TraccySolutions/1892-Eten-en-Drinken-Trapverlichting-PCB-design/Pics/Raw/Trap4.jpg

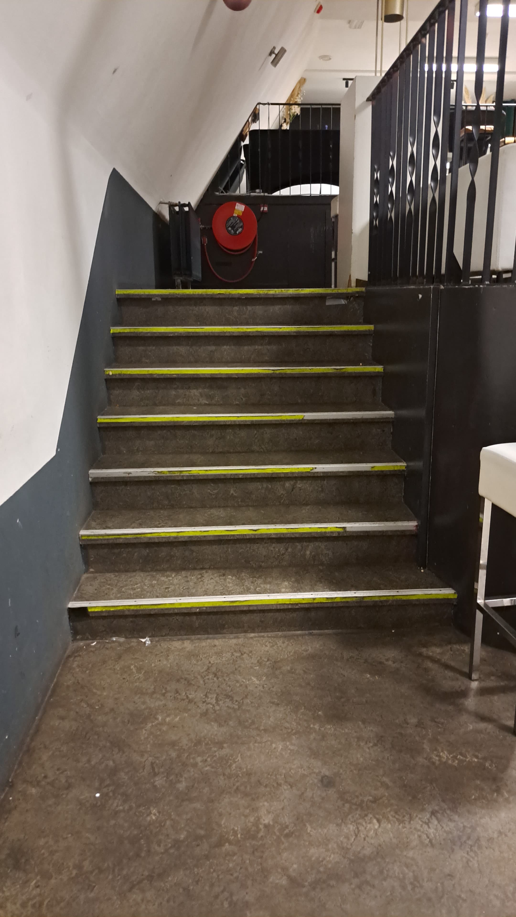
Pics/Raw/Trap4.jpg
