TraccySolutions/1892-Eten-en-Drinken-Trapverlichting-PCB-design/Pics/Raw/Trap2.jpg

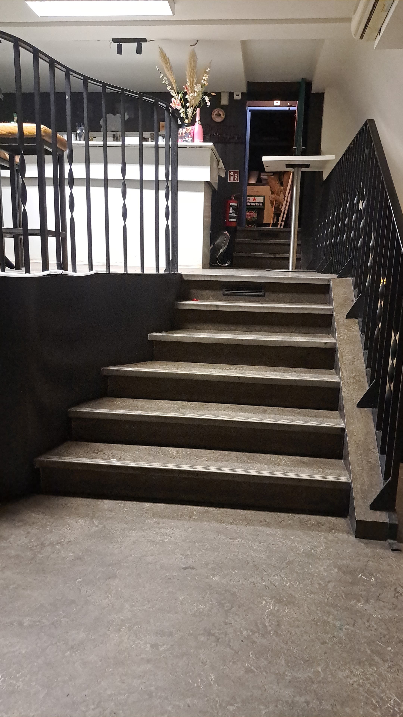
Pics/Raw/Trap2.jpg
