TraccySolutions/1892-Eten-en-Drinken-Trapverlichting-PCB-design/Pics/Raw/Trap1.jpg

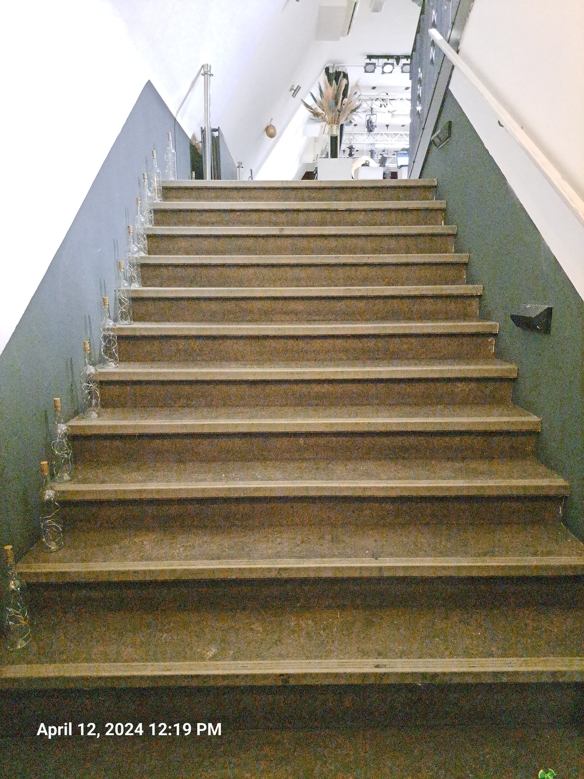
Pics/Raw/Trap1.jpg
