TraccySolutions/1892-Eten-en-Drinken-Trapverlichting-PCB-design/Pics/Raw/Trap3.jpg

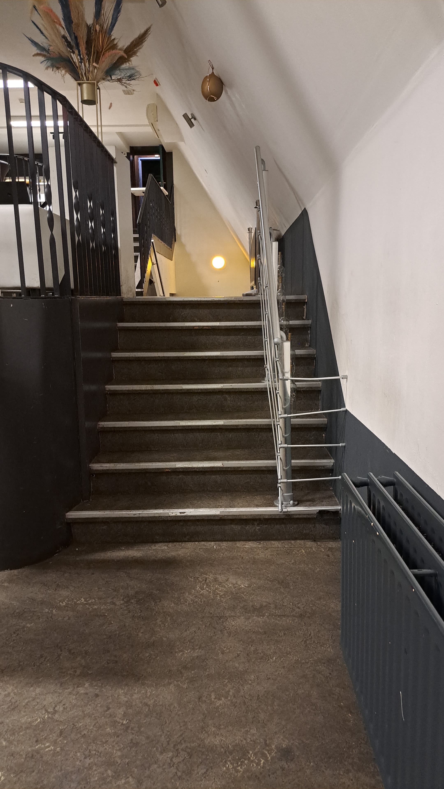
Pics/Raw/Trap3.jpg
