TraccySolutions/1892-Eten-en-Drinken-Trapverlichting-PCB-design/Schematic/V1/Case/PCB.step

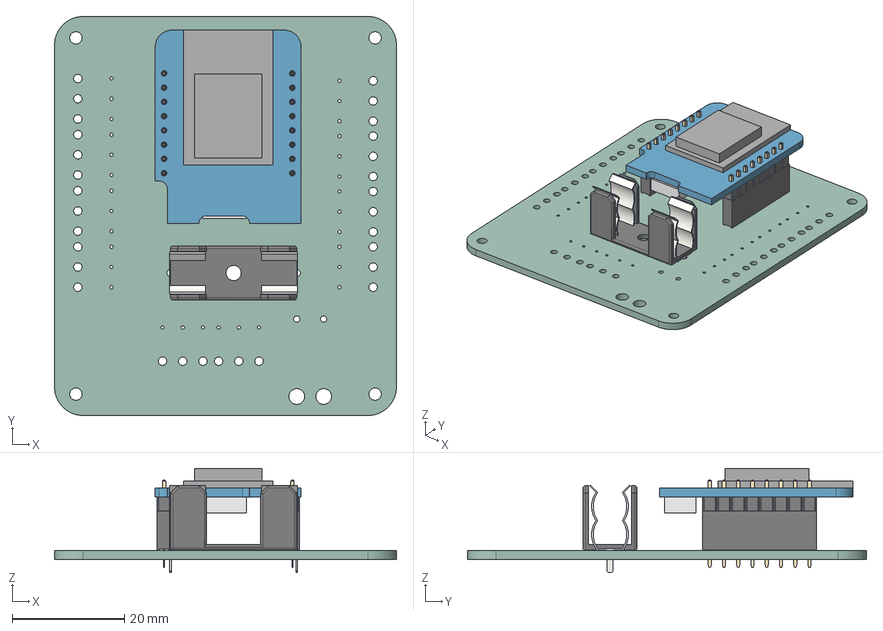
[picture p5: CAD file, 2024-04-18, an earlier design]
Schematic/V1/Case/PCB.step
61.0 x 71.1 x 18.6 mm
wemos_d1_mini_light
PinHeader_1x08_P254mm_Vertical x 2
PinSocket_1x08_P254mm_Vertical x 2
A_Schurter_0031_8201
V1_PCB
