TraccySolutions/1892-Eten-en-Drinken-Trapverlichting-PCB-design/(list of files, cad)

Other CAD files:
Schematic/V3/LIB_1812L200_16DR/1812L200_16DR/Allegro/1812l010dr.psm
Schematic/V3/LIB_1812L200_16DR/1812L200_16DR/DEHDL/1812l200_16dr/chips/chips.prt
