TraccySolutions/1892-Eten-en-Drinken-Trapverlichting-PCB-design/Schematic/V3/V3.kicad_pcb

## KiCad design Schematic/V3/V3.kicad_pcb (2024-08-20)

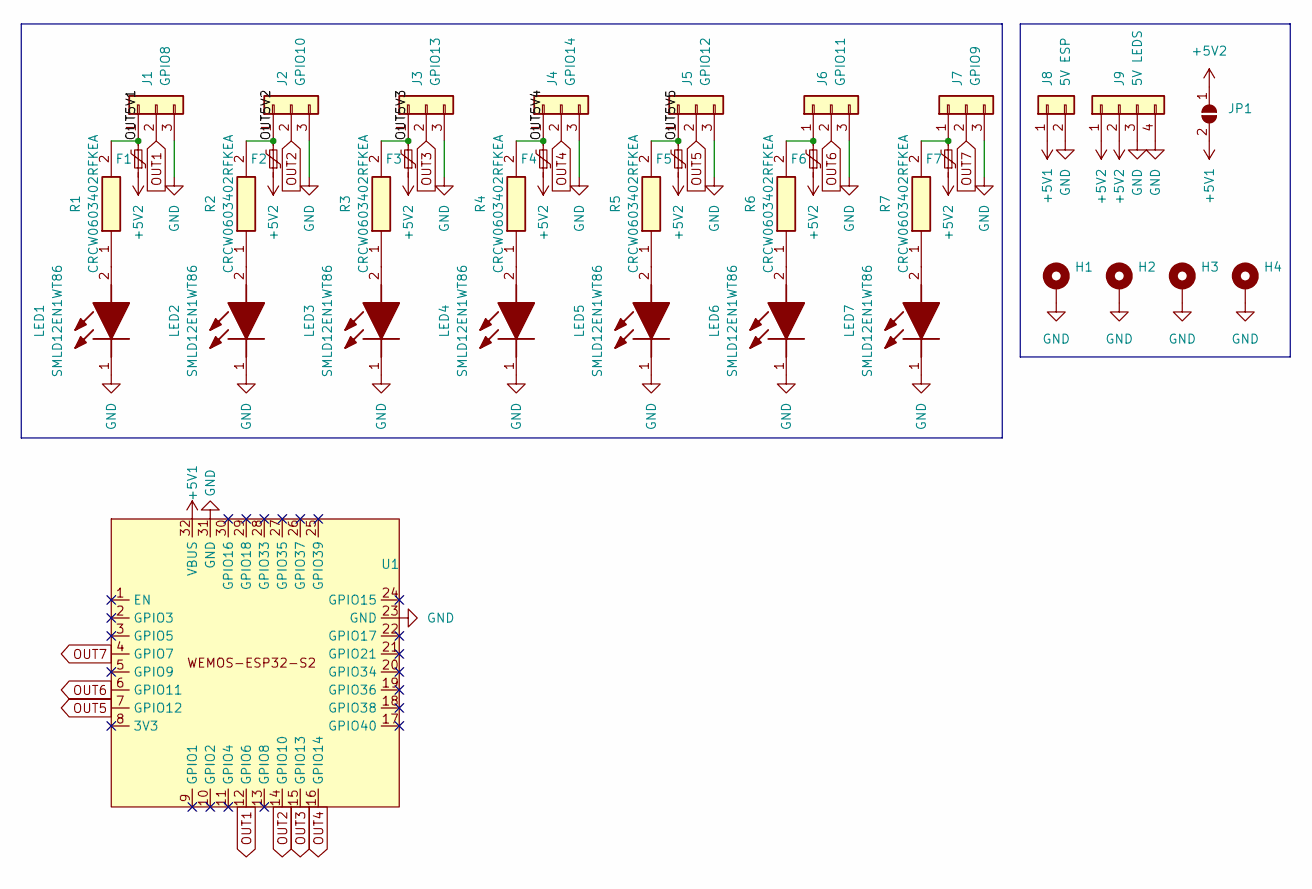
[picture p6: schematic V3.kicad_sch]

Parts:
F1, F2, F3, F4, F5, F6, F7: Polyfuse_Small; 1812L010DR; Mouser Part Number 652-MF-MSMF260-2
H1, H2, H3, H4: MountingHole_Pad; MountingHole_3.2mm_M3_ISO14580_Pad
J1: GPIO8; Custom solderWire 1x03 with relief
J2: GPIO10; Custom solderWire 1x03 with relief
J3: GPIO13; Custom solderWire 1x03 with relief
J4: GPIO14; Custom solderWire 1x03 with relief
J5: GPIO12; Custom solderWire 1x03 with relief
J6: GPIO11; Custom solderWire 1x03 with relief
J7: GPIO9; Custom solderWire 1x03 with relief
J8: 5V ESP; SolderWire-0.25sqmm_1x02_P4.2mm_D0.65mm_OD1.7mm_Relief
J9: 5V LEDS; Custom SolderWire 1x04 with relief
JP1: SolderJumper_2_Open; SolderJumper-2_P1.3mm_Open_TrianglePad1.0x1.5mm
LED1, LED2, LED3, LED4, LED5, LED6, LED7: SMLD12EN1WT86; LEDM168X65N; Mouser Part Number 755-SMLD12EN1WT86
R1, R2, R3, R4, R5, R6, R7: CRCW0603402RFKEA; RESC1608X50N; Mouser Part Number 71-CRCW0603-402-E3
U1: WEMOS-ESP32-S2

Connections:
+5V1: J8.1, JP1.2 (B), U1.32 (VBUS)
+5V2: F1.1, F2.1, F3.1, F4.1, F5.1, F6.1, F7.1, J9.1, J9.2, JP1.1 (A)
/OUT5V1: F1.2, J1.1, R1.2
/OUT5V2: F2.2, J2.1, R2.2
/OUT5V3: F3.2, J3.1, R3.2
/OUT5V4: F4.2, J4.1, R4.2
/OUT5V5: F5.2, J5.1, R5.2
GND: H1.1, H2.1, H3.1, H4.1, J1.3, J2.3, J3.3, J4.3, J5.3, J6.3, J7.3, J8.2, J9.3, J9.4, LED1.1 (K), LED2.1 (K), LED3.1 (K), LED4.1 (K), LED5.1 (K), LED6.1 (K), LED7.1 (K), U1.23 (GND), U1.31 (GND)
unnamed: F6.2, J6.1, R6.2
unnamed: F7.2, J7.1, R7.2
unnamed: LED1.2 (A), R1.1
unnamed: LED2.2 (A), R2.1
unnamed: LED3.2 (A), R3.1
unnamed: LED4.2 (A), R4.1
unnamed: LED5.2 (A), R5.1
unnamed: LED6.2 (A), R6.1
unnamed: LED7.2 (A), R7.1
OUT1: J1.2, U1.12 (GPIO6)
OUT2: J2.2, U1.14 (GPIO10)
OUT3: J3.2, U1.15 (GPIO13)
OUT4: J4.2, U1.16 (GPIO14)
OUT5: J5.2, U1.7 (GPIO12)
OUT6: J6.2, U1.6 (GPIO11)
OUT7: J7.2, U1.4 (GPIO7)

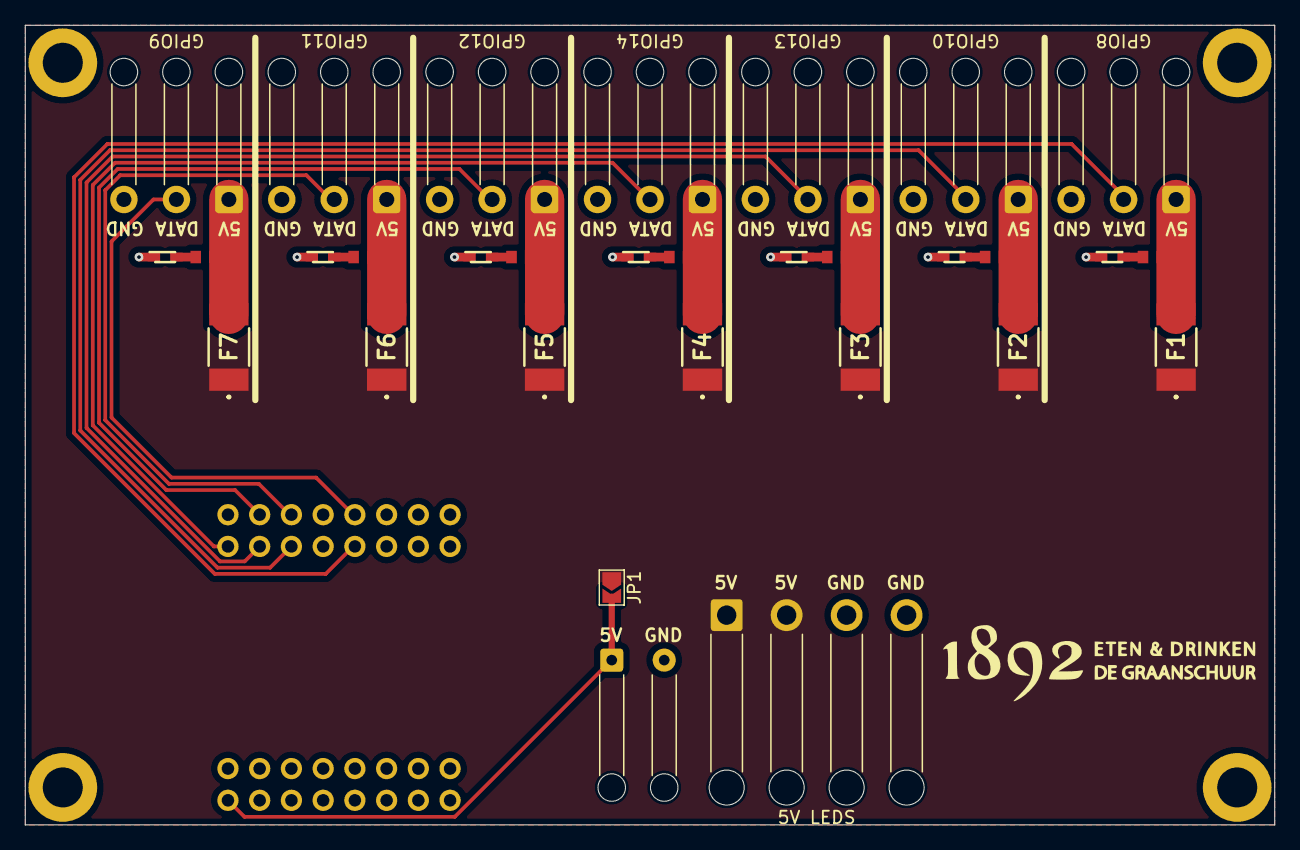
[picture p7: board V3.kicad_pcb from above]

Board: 2 copper layers, 100.0 x 64.0 mm, 36 parts (0 on the bottom side), 24 nets.
