TraccySolutions/1892-Eten-en-Drinken-Trapverlichting-PCB-design/Schematic/V2/V2.kicad_pcb

## KiCad design Schematic/V2/V2.kicad_pcb (2024-08-20, an earlier design)

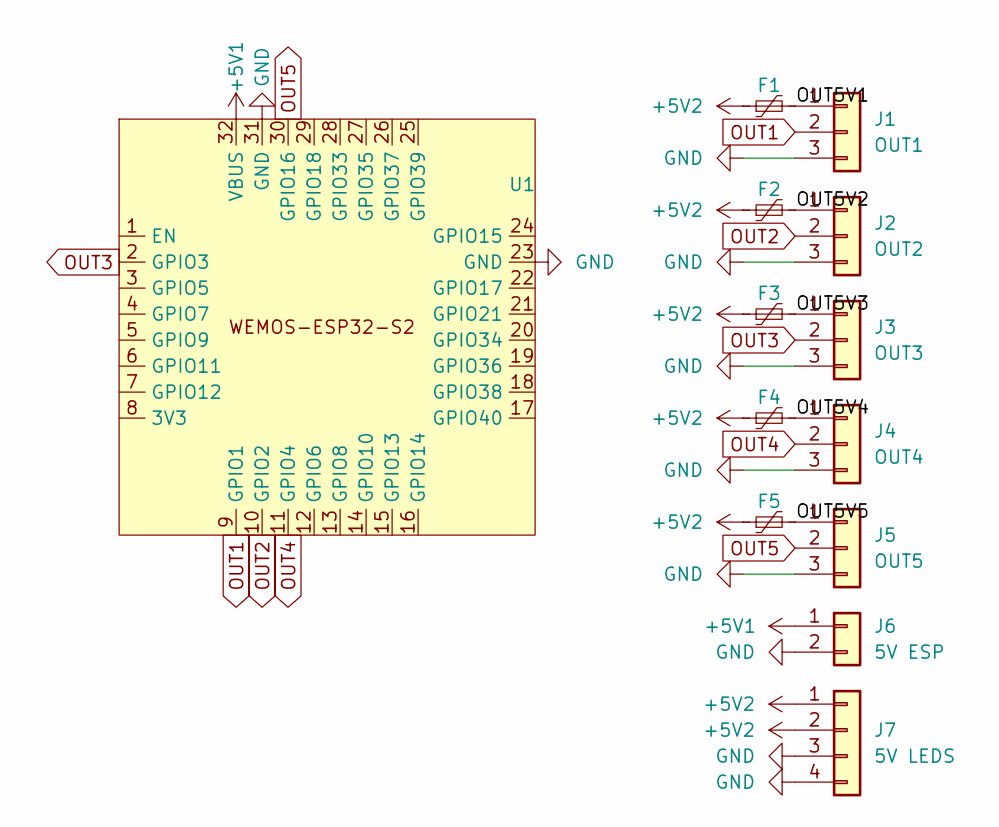
[picture p8: schematic V2.kicad_sch]

Parts:
F1, F2, F3, F4, F5: Polyfuse_Small; 1812L010DR
J1: OUT1; SolderWire-0.25sqmm_1x03_P4.2mm_D0.65mm_OD1.7mm_Relief
J2: OUT2; SolderWire-0.25sqmm_1x03_P4.2mm_D0.65mm_OD1.7mm_Relief
J3: OUT3; SolderWire-0.25sqmm_1x03_P4.2mm_D0.65mm_OD1.7mm_Relief
J4: OUT4; SolderWire-0.25sqmm_1x03_P4.2mm_D0.65mm_OD1.7mm_Relief
J5: OUT5; SolderWire-0.25sqmm_1x03_P4.2mm_D0.65mm_OD1.7mm_Relief
J6: 5V ESP; SolderWire-0.25sqmm_1x02_P4.2mm_D0.65mm_OD1.7mm_Relief
J7: 5V LEDS; SolderWire-0.75sqmm_1x04_P4.8mm_D1.25mm_OD2.3mm_Relief
U1: WEMOS-ESP32-S2

Connections:
+5V1: J6.1, U1.32 (VBUS)
+5V2: F1.1, F2.1, F3.1, F4.1, F5.1, J7.1, J7.2
/OUT5V1: F1.2, J1.1
/OUT5V2: F2.2, J2.1
/OUT5V3: F3.2, J3.1
/OUT5V4: F4.2, J4.1
/OUT5V5: F5.2, J5.1
GND: J1.3, J2.3, J3.3, J4.3, J5.3, J6.2, J7.3, J7.4, U1.23 (GND), U1.31 (GND)
OUT1: J1.2, U1.9 (GPIO1)
OUT2: J2.2, U1.10 (GPIO2)
OUT3: J3.2, U1.2 (GPIO3)
OUT4: J4.2, U1.11 (GPIO4)
OUT5: J5.2, U1.30 (GPIO16)

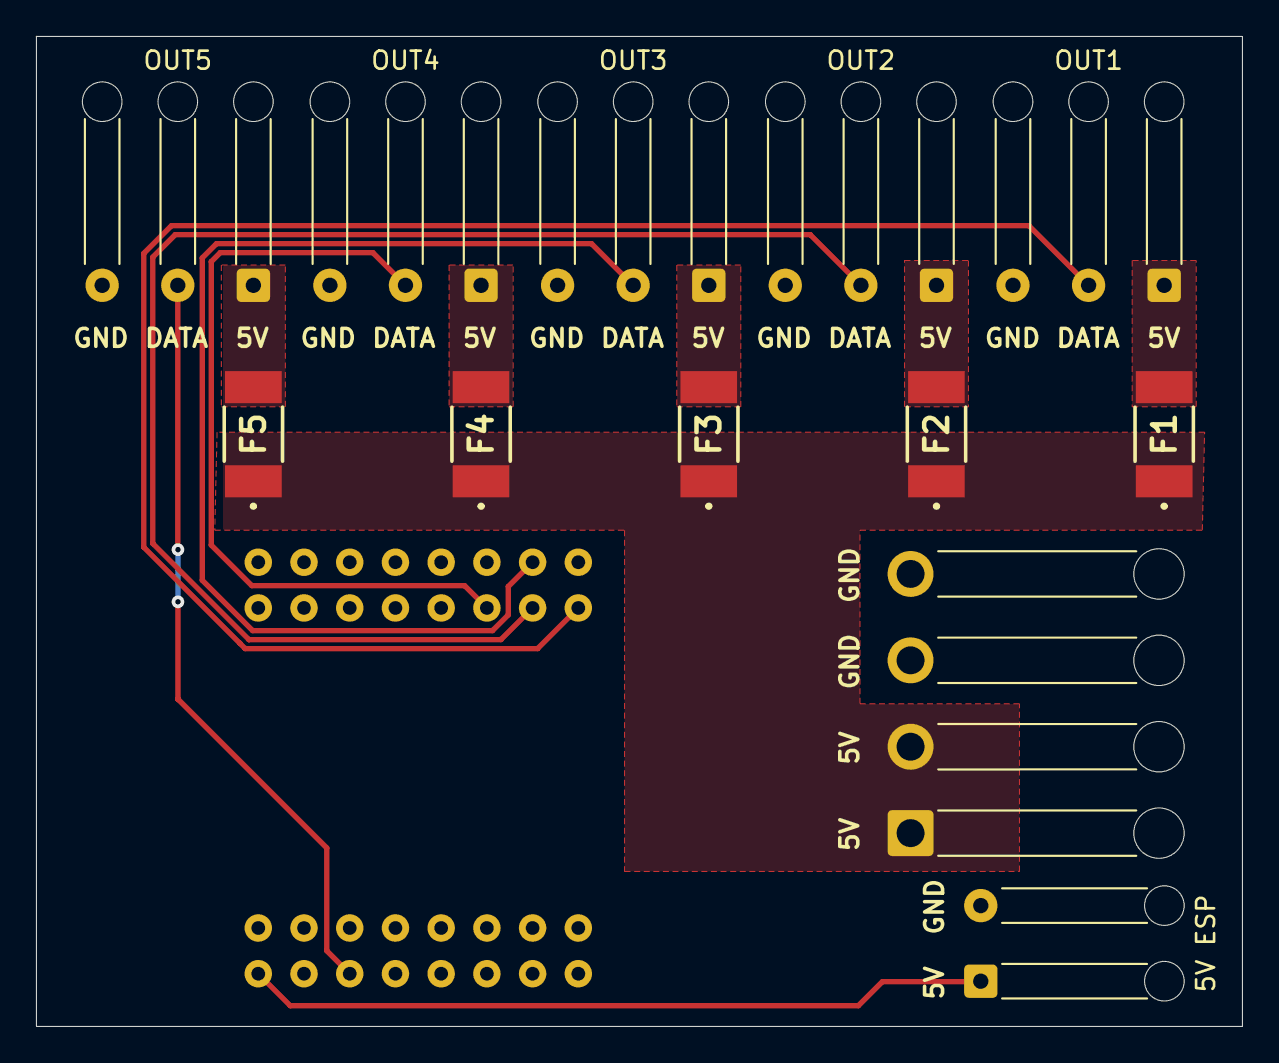
[picture p9: board V2.kicad_pcb from above]

Board: 2 copper layers, 67.0 x 55.0 mm, 13 parts (0 on the bottom side), 13 nets.
