TraccySolutions/1892-Eten-en-Drinken-Trapverlichting-PCB-design/Schematic/V1/V1.kicad_pcb

## KiCad design Schematic/V1/V1.kicad_pcb (2024-04-18, an earlier design)

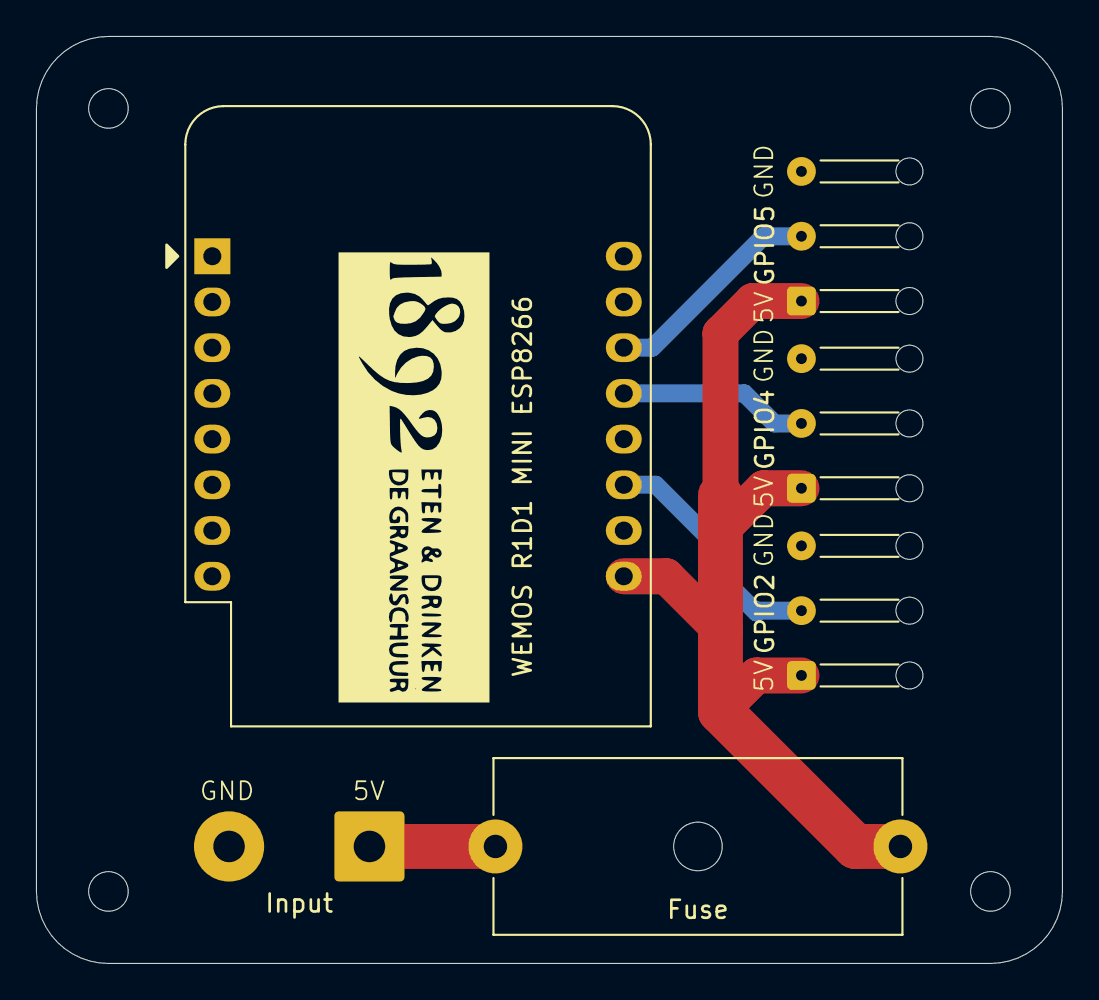
[picture p10: board V1.kicad_pcb from above]

Board: 2 copper layers, 57.0 x 51.5 mm, 10 parts (0 on the bottom side), 6 nets.

Parts:
Fuse: Fuse; Fuseholder_Cylinder-5x20mm_Schurter_0031_8201_Horizontal_Op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
GPIO2, GPIO4, GPIO5: Conn_01x03_Socket; SolderWire-0.1sqmm_1x03_P3.6mm_D0.4mm_OD1mm_Relief
H1, H2, H3, H4: MountingHole; MountingHole_2.2mm_M2
Input: Conn_01x02_Socket; SolderWire-1sqmm_1x02_P7.8mm_D1.4mm_OD3.9mm
WEMOS R1D1 MINI ESP8266: WeMos_D1_mini; WEMOS_D1_mini_light

Connections:
+5V: Fuse.1, GPIO2.1, GPIO4.1, GPIO5.1, WEMOS R1D1 MINI ESP8266.9 (5V)
D1: GPIO5.2, WEMOS R1D1 MINI ESP8266.14 (SCL/D1)
D2: GPIO4.2, WEMOS R1D1 MINI ESP8266.13 (SDA/D2)
D4: GPIO2.2, WEMOS R1D1 MINI ESP8266.11 (D4)
GND: GPIO2.3, GPIO4.3, GPIO5.3, Input.2, WEMOS R1D1 MINI ESP8266.10 (GND)
unnamed: Fuse.2, Input.1
