TraccySolutions/1892-Eten-en-Drinken-Trapverlichting-PCB-design/(commit log)

2024-04-18 added img and pcb
    [PCB.step, Traptredes LED.xlsx, V1.kicad_pcb, V1.kicad_sch, bom.csv, designators.csv, positions.csv]
2024-07-02 Started V2
    [V2.kicad_pcb, V2.kicad_sch]
2024-07-02 Added V2
    [1812L200_16DR.stp, 1812l010dr.psm, EDI2CAP.CFG, V2.kicad_pcb, V2.kicad_sch, chips.prt]
2024-07-02 Added prduciton files
    [bom.csv, designators.csv, positions.csv]
2024-08-13 Added support for two 18 AWG wires as 5V input to allow 14A and updated traces as needed.
    [V2.kicad_pcb, V2.kicad_sch, bom.csv, designators.csv]
2024-08-20 Added V3
    Added two additional outputs.
    Added SolderPad for ESP power.
    Increased hole sizes for outputs (0,85 -> 1,2mm) and esp (0,762 -> 1,0mm).
    Added power indicator leds after fuses.
    Did not change Fuse size due to cost. (20 EUR) and from 2.6A to 3A is not that important I think.
    Should look for cheaper leds.
    [1812L200_16DR.stp, 1812l010dr.psm, EDI2CAP.CFG, V2.kicad_pcb, V3.kicad_pcb, V3.kicad_sch, bom.csv, chips.prt]
2024-08-20 Updated Production files
    Correct bom is the one not in the production folder.
    [BOM.csv]
